glenoverby/Sequencer/Hardware/Mega328basic1/pcb-bottom.pdf

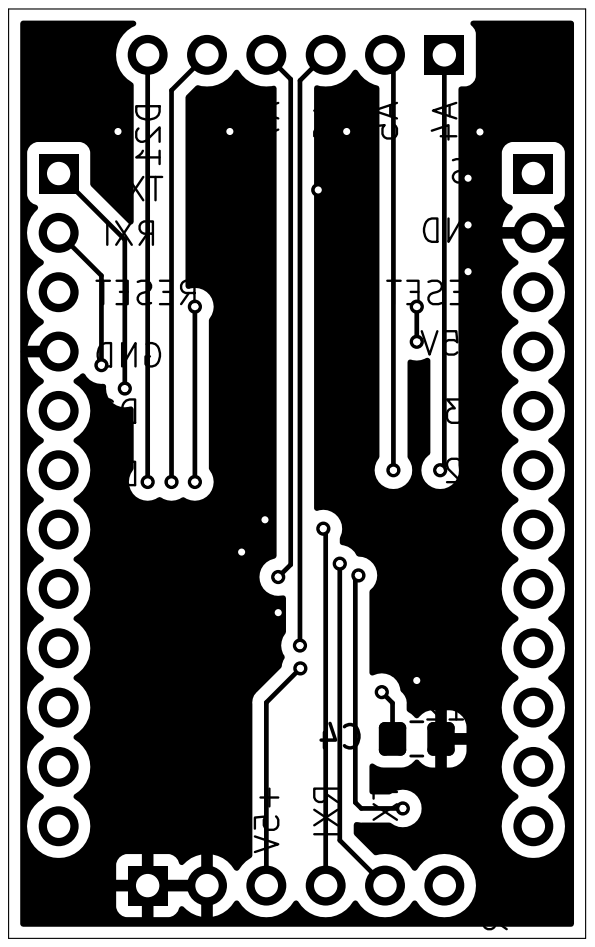
[picture p1: page 1]
