glenoverby/Sequencer/Hardware/Mega328basic1/pcb.pdf

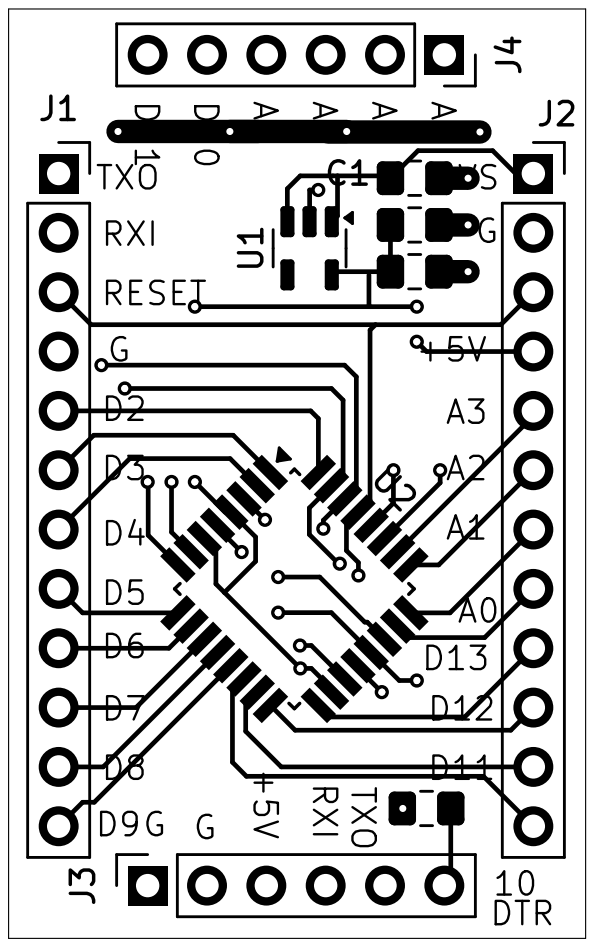
[picture p2: page 1]
