glenoverby/Sequencer/Hardware/sequencer3/pcb.pdf

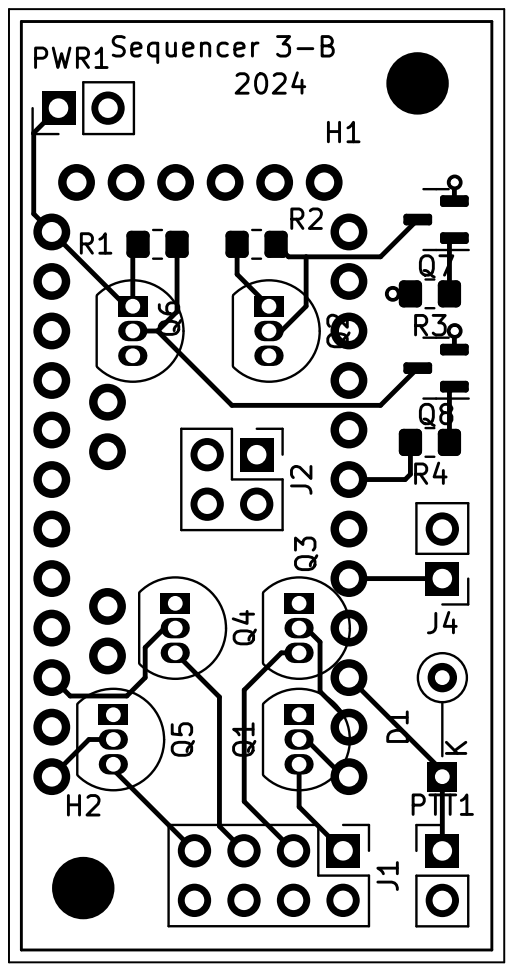
[picture p3: page 1]
