glenoverby/Sequencer/Hardware/sequencer3/schematic.pdf

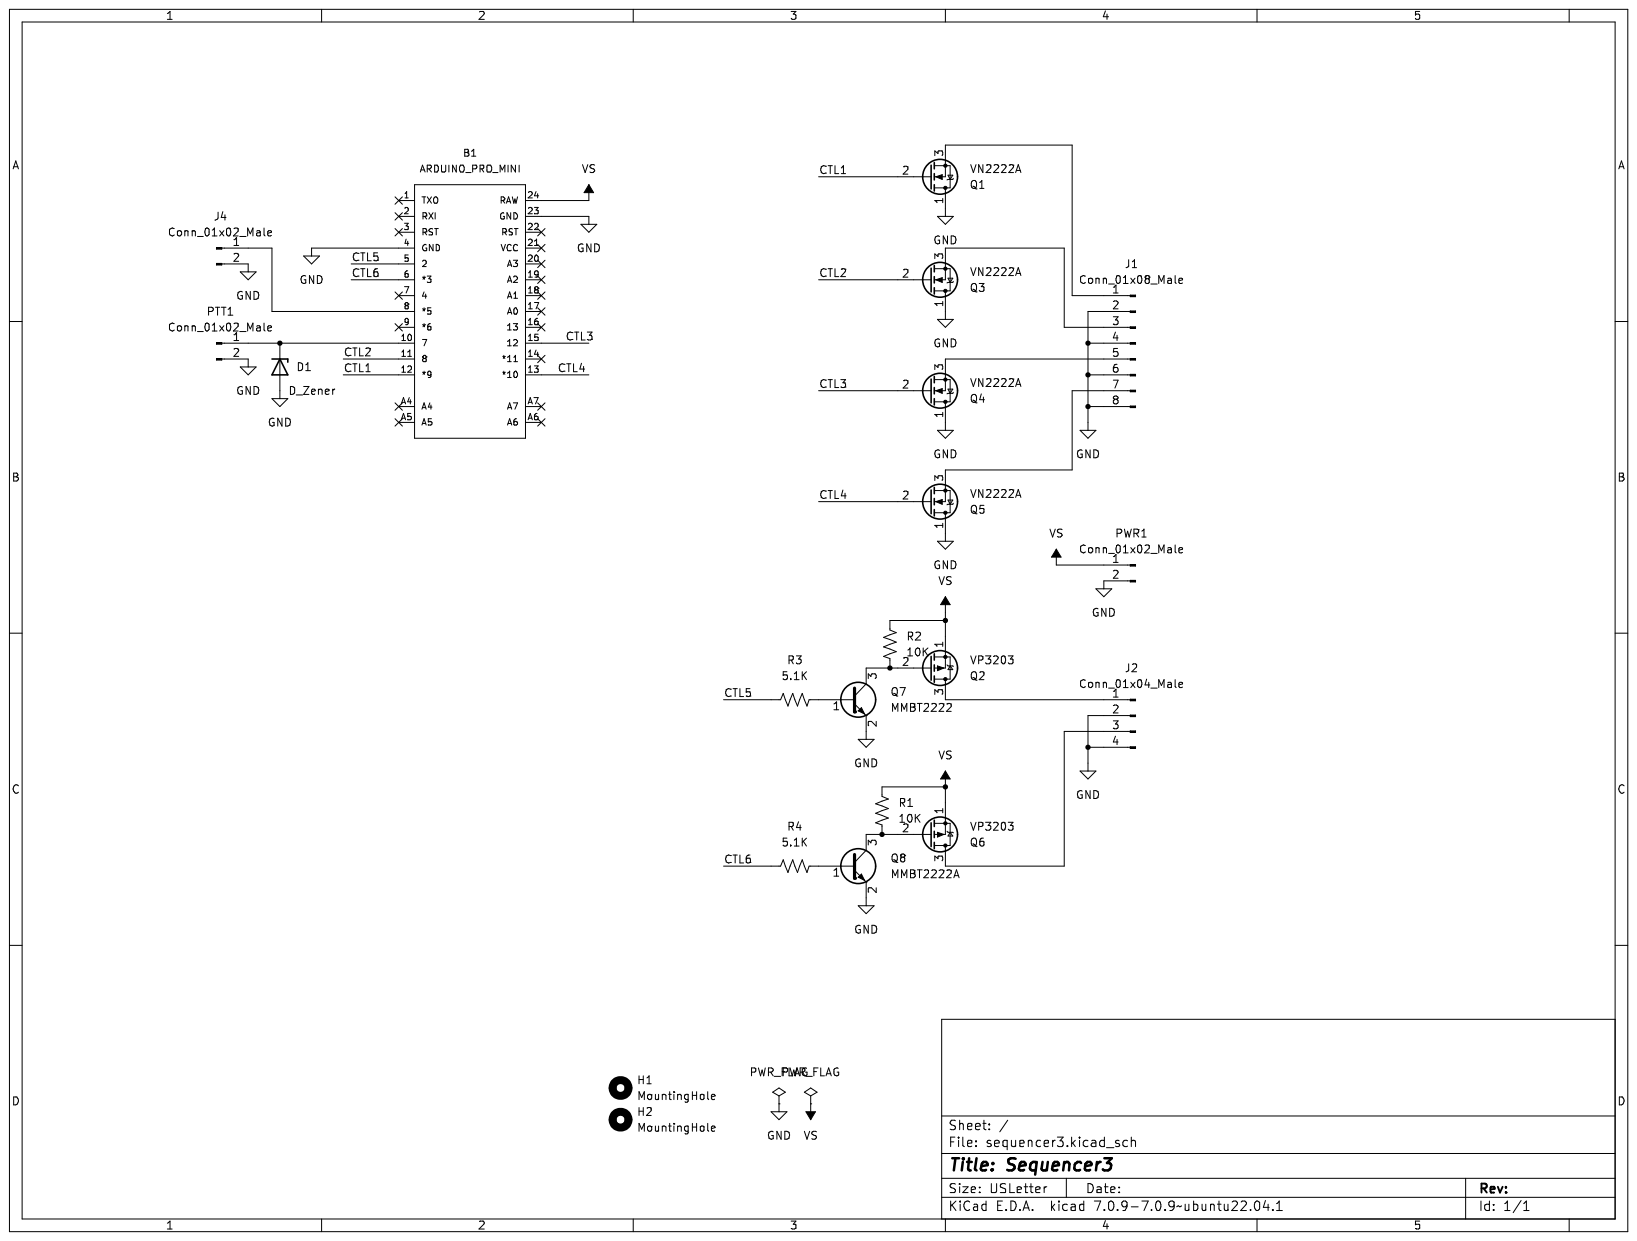
[picture p4: page 1]
