glenoverby/Sequencer/Hardware/Mega328basic1/Mega328basic1.kicad_pcb

## KiCad design Hardware/Mega328basic1/Mega328basic1.kicad_pcb (2026-10-20)

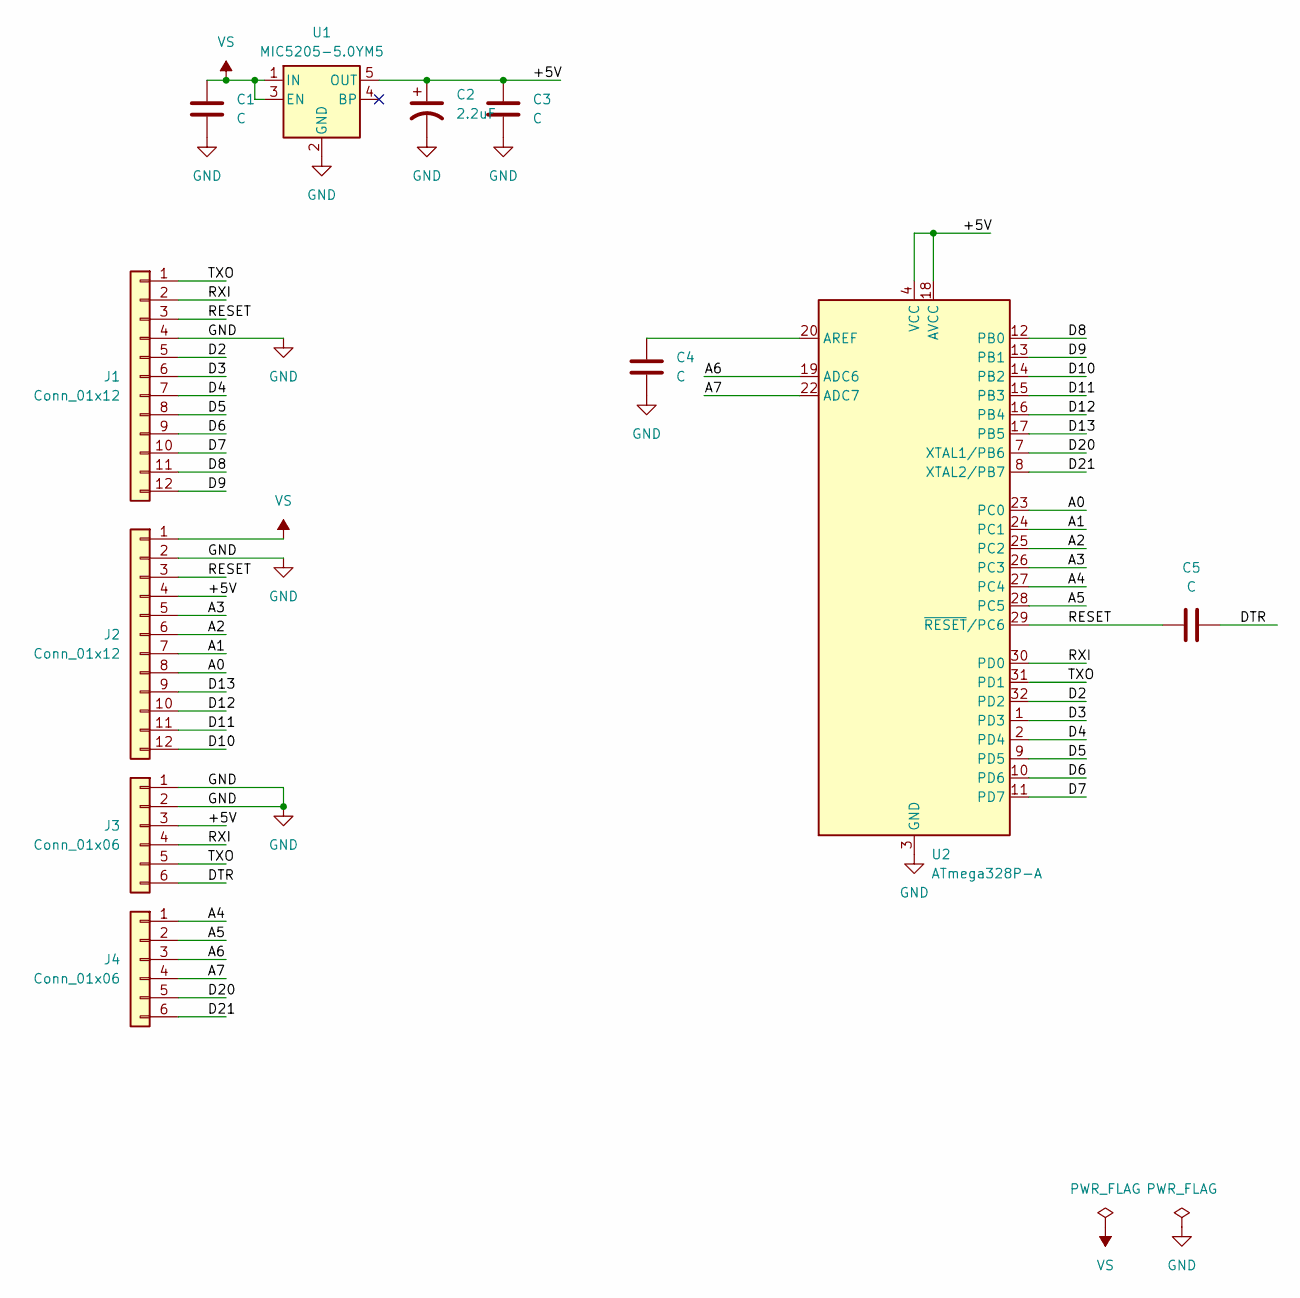
[picture p5: schematic Mega328basic1.kicad_sch]

Parts:
C1, C3, C4, C5: C; C_0805_2012Metric_Pad1.18x1.45mm_HandSolder
C2: 2.2uF; C_0805_2012Metric_Pad1.18x1.45mm_HandSolder
J1, J2: Conn_01x12; PinSocket_1x12_P2.54mm_Vertical
J3, J4: Conn_01x06; PinSocket_1x06_P2.54mm_Vertical
U1: MIC5205-5.0YM5; SOT-23-5
U2: ATmega328P-A; TQFP-32_7x7mm_P0.8mm

Connections:
/+5V: C2.1, C3.1, J2.4, J3.3, U1.5 (OUT), U2.4 (VCC), U2.6 (VCC), U2.18 (AVCC)
/A0: J2.8, U2.23 (PC0)
/A1: J2.7, U2.24 (PC1)
/A2: J2.6, U2.25 (PC2)
/A3: J2.5, U2.26 (PC3)
/A4: J4.1, U2.27 (PC4)
/A5: J4.2, U2.28 (PC5)
/A6: J4.3, U2.19 (ADC6)
/A7: J4.4, U2.22 (ADC7)
/D2: J1.5, U2.32 (PD2)
/D3: J1.6, U2.1 (PD3)
/D4: J1.7, U2.2 (PD4)
/D5: J1.8, U2.9 (PD5)
/D6: J1.9, U2.10 (PD6)
/D7: J1.10, U2.11 (PD7)
/D8: J1.11, U2.12 (PB0)
/D9: J1.12, U2.13 (PB1)
/D10: J2.12, U2.14 (PB2)
/D11: J2.11, U2.15 (PB3)
/D12: J2.10, U2.16 (PB4)
/D13: J2.9, U2.17 (PB5)
/D20: J4.5, U2.7 (XTAL1/PB6)
/D21: J4.6, U2.8 (XTAL2/PB7)
/DTR: C5.2, J3.6
/RESET: C5.1, J1.3, J2.3, U2.29 (~RESET/PC6)
/RXI: J1.2, J3.4, U2.30 (PD0)
/TXO: J1.1, J3.5, U2.31 (PD1)
GND: C1.2, C2.2, C3.2, C4.2, J1.4, J2.2, J3.1, J3.2, U1.2 (GND), U2.3 (GND), U2.5 (GND), U2.21 (GND)
unnamed: C4.1, U2.20 (AREF)
VS: C1.1, J2.1, U1.1 (IN), U1.3 (EN)

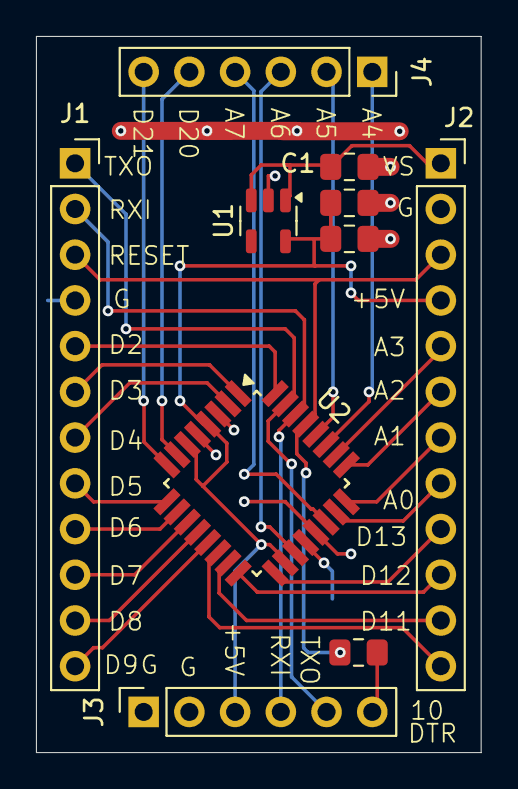
[picture p6: board Mega328basic1.kicad_pcb from above]

Board: 2 copper layers, 24.7 x 39.8 mm, 11 parts (1 on the bottom side), 30 nets.
