glenoverby/Sequencer/Hardware/sequencer3/sequencer3.kicad_pcb

## KiCad design Hardware/sequencer3/sequencer3.kicad_pcb (2026-10-20)

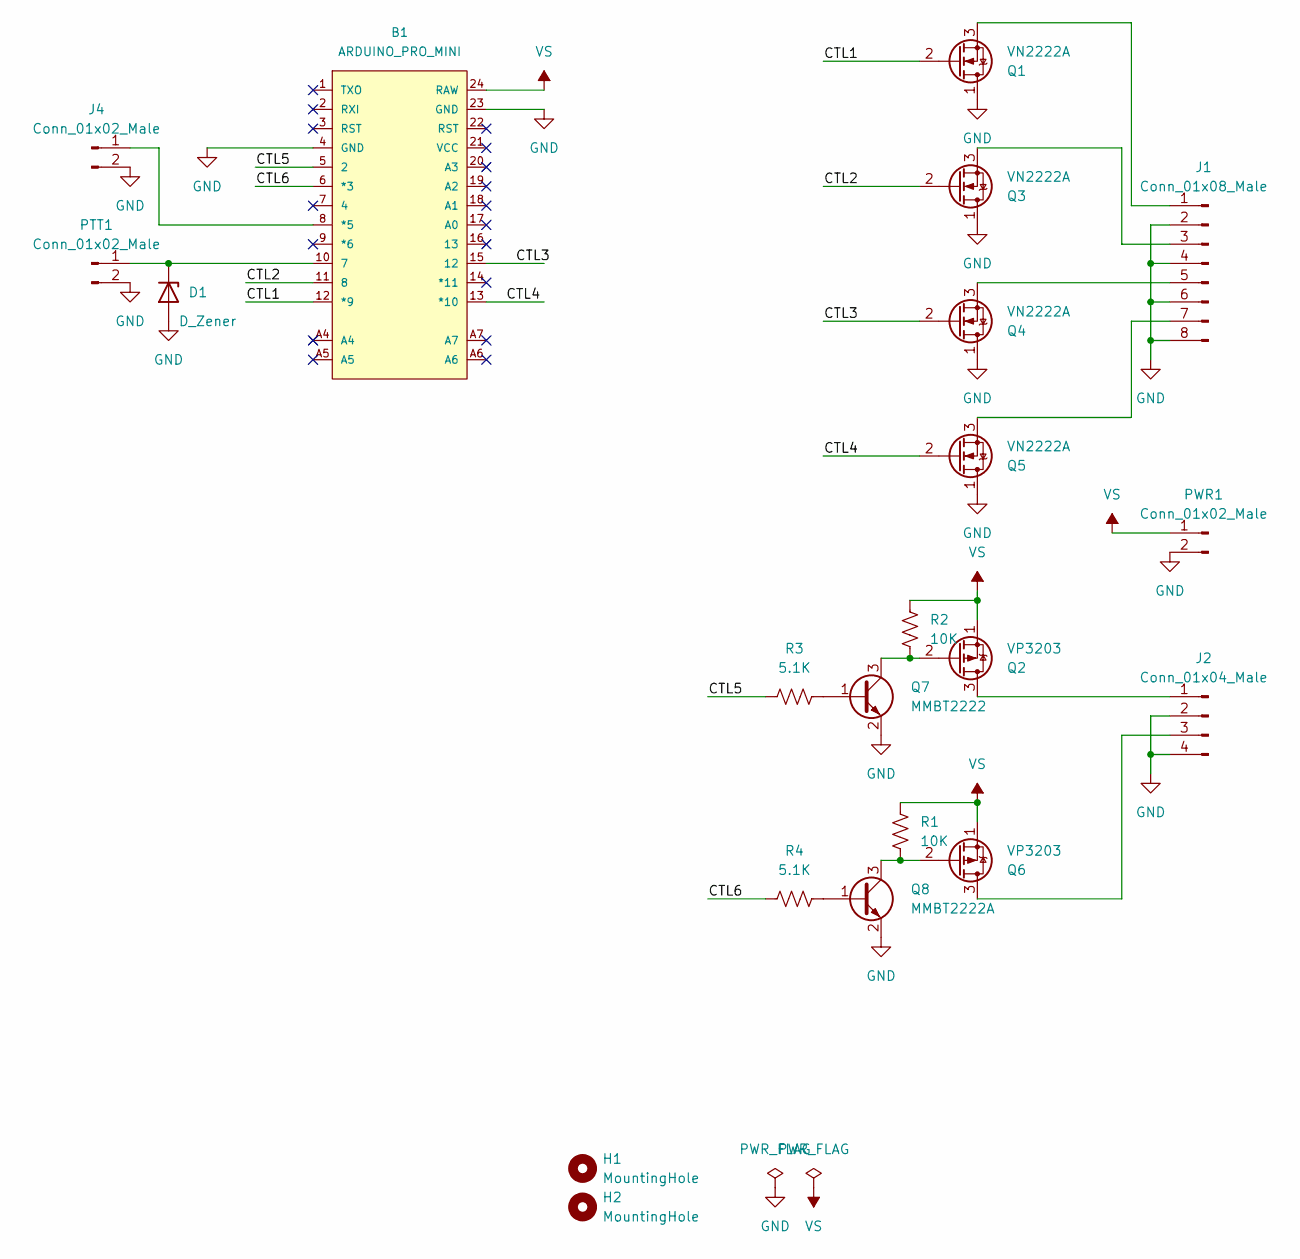
[picture p7: schematic sequencer3.kicad_sch]

Parts:
B1: ARDUINO_PRO_MINI
D1: D_Zener; D_DO-34_SOD68_P5.08mm_Vertical_KathodeUp
H1, H2: MountingHole; MountingHole_3.2mm_M3
J1: Conn_01x08_Male; PinHeader_2x04_P2.54mm_Vertical
J2: Conn_01x04_Male; PinHeader_2x02_P2.54mm_Vertical
J4: Conn_01x02_Male; PinHeader_1x02_P2.54mm_Vertical
PTT1: Conn_01x02_Male; PinHeader_1x02_P2.54mm_Vertical
PWR1: Conn_01x02_Male; PinHeader_1x02_P2.54mm_Vertical
Q1, Q3, Q4, Q5: VN2222A; TO-92_Inline
Q2, Q6: VP3203; TO-92_Inline
Q7: MMBT2222; SOT-23
Q8: MMBT2222A; SOT-23
R1, R2: 10K; R_0805_2012Metric_Pad1.20x1.40mm_HandSolder
R3, R4: 5.1K; R_0805_2012Metric_Pad1.20x1.40mm_HandSolder

Connections:
/CTL1: B1.12 (*9), Q1.2 (G)
/CTL2: B1.11 (8), Q3.2 (G)
/CTL3: B1.15 (12), Q4.2 (G)
/CTL4: B1.13 (*10), Q5.2 (G)
/CTL5: B1.5 (2), R3.2
/CTL6: B1.6 (*3), R4.2
GND: B1.4 (GND), B1.23 (GND), D1.2 (A), J1.2, J1.4, J1.6, J1.8, J2.2, J2.4, J4.2, PTT1.2, PWR1.2, Q1.1 (D), Q3.1 (D), Q4.1 (D), Q5.1 (D), Q7.2 (E), Q8.2 (E)
unnamed: B1.10 (7), D1.1 (K), PTT1.1
unnamed: B1.8 (*5), J4.1
unnamed: J1.1, Q1.3 (S)
unnamed: J1.3, Q3.3 (S)
unnamed: J1.5, Q4.3 (S)
unnamed: J1.7, Q5.3 (S)
unnamed: J2.1, Q2.3 (D)
unnamed: J2.3, Q6.3 (D)
unnamed: Q2.2 (G), Q7.3 (C), R2.2
unnamed: Q6.2 (G), Q8.3 (C), R1.2
unnamed: Q7.1 (B), R3.1
unnamed: Q8.1 (B), R4.1
VS: B1.24 (RAW), PWR1.1, Q2.1 (S), Q6.1 (S), R1.1, R2.1

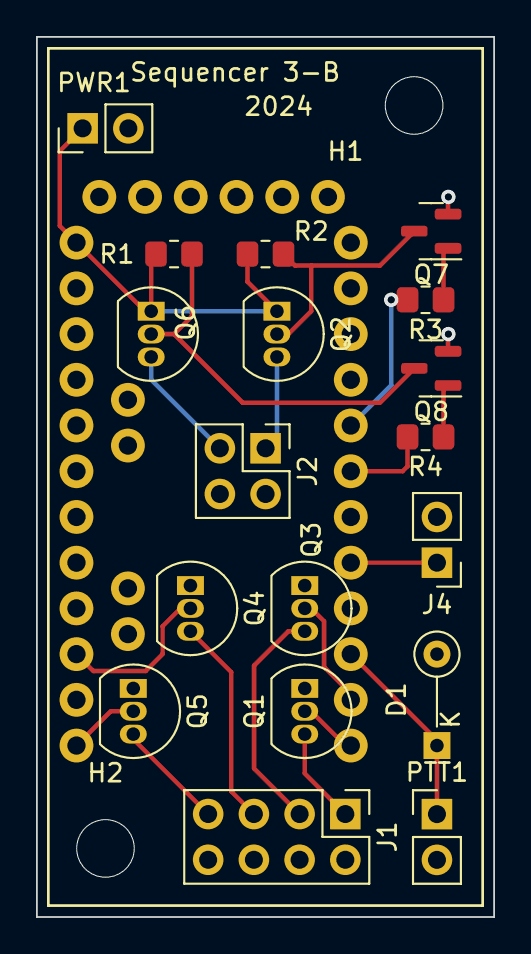
[picture p8: board sequencer3.kicad_pcb from above]

Board: 2 copper layers, 25.4 x 48.9 mm, 21 parts (1 on the bottom side), 20 nets.
